alphaseneca/chronopixel-pcb/chronopixel-pcb.kicad_pcb

## KiCad design chronopixel-pcb.kicad_pcb (2026-10-25)

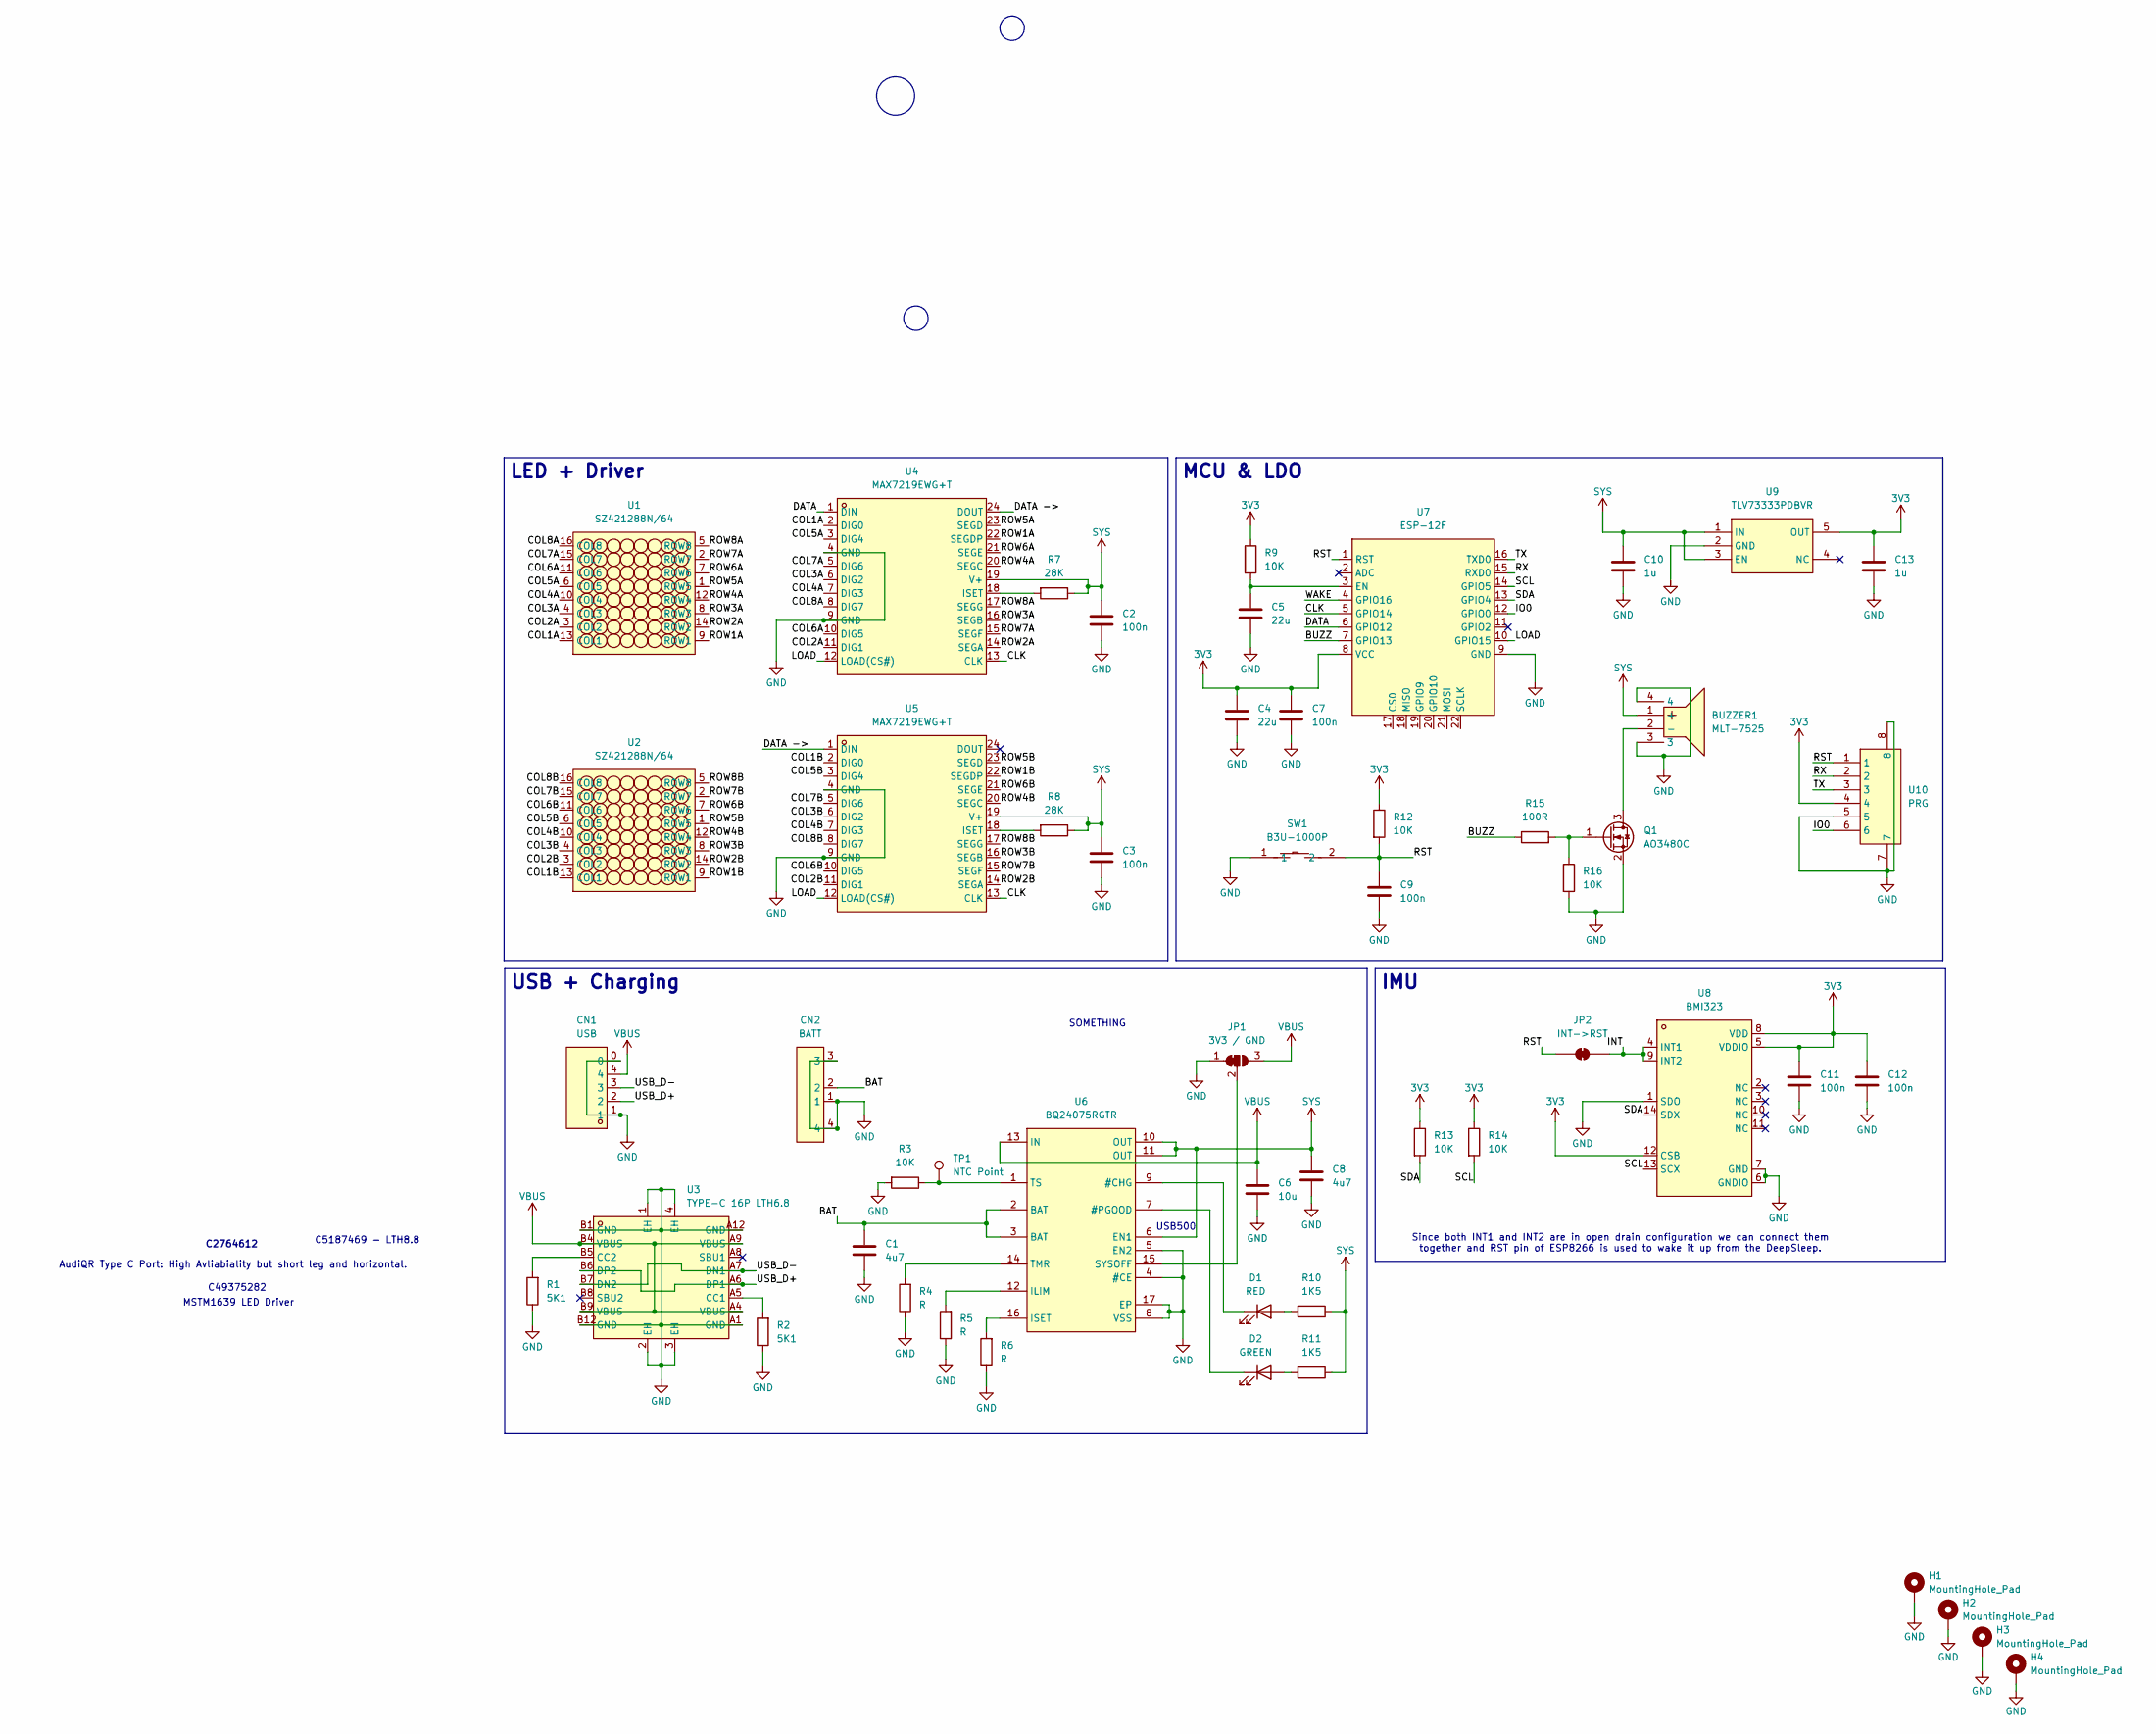
[picture p1: schematic chronopixel-pcb.kicad_sch]

Parts:
BUZZER1: MLT-7525; BUZ-SMD_4P-L7.5-W7.5-P7.59-TL; MPN MLT-7525
C1, C8: 4u7; C_0805_2012Metric; MPN CL21A475KAQNNNE
C2, C3, C7, C9, C11, C12: 100n; C_0603_1608Metric; MPN CL10B104KB8NNNC
C4, C5: 22u; C_0805_2012Metric; MPN CL21A226MAYNNNE
C6: 10u; C_0805_2012Metric; MPN CL21A106KAYNNNE
C10, C13: 1u; C_0805_2012Metric; MPN CL21B105KBFNNNE
CN1: USB; CONN-SMD_BM04B-SRSS-TB; MPN BM04B-SRSS-TB(LF)(SN)
CN2: BATT; CONN-SMD_2P-P1.00_SM02B-SRSS-TB-LF-SN; MPN SM02B-SRSS-TB(LF)(SN)
D1: RED; LED_0603_1608Metric; MPN XL-1608SURC-06
D2: GREEN; LED_0603_1608Metric; MPN XL-1608UGC-04
H1, H2, H3, H4: MountingHole_Pad; MountingHole_2.2mm_M2_Pad_Via
JP1: 3V3 / GND; SolderJumper-3_P1.3mm_Bridged12_RoundedPad1.0x1.5mm
JP2: INT->RST; SolderJumper-2_P1.3mm_Bridged_RoundedPad1.0x1.5mm
Q1: AO3480C; SOT-23; MPN AO3400A
R1, R2: 5K1; R_0603_1608Metric; MPN RC0603FR-075K1L
R3, R9, R12, R13, R14, R16: 10K; R_0603_1608Metric; MPN RC0603FR-0710KL
R4, R5, R6: R; R_0603_1608Metric
R7, R8: 28K; R_0603_1608Metric; MPN RC0603FR-0728KL
R10, R11: 1K5; R_0603_1608Metric; MPN RC0603FR-071K5L
R15: 100R; R_0603_1608Metric; MPN RC0603FR-07100RL
SW1: B3U-1000P; KEY-SMD_B3U-1000PM; MPN B3U-1000P
TP1: NTC Point; TestPoint_Pad_D1.0mm
U1, U2: SZ421288N/64; LED-SEG-TH_SZ421288N-64; MPN SZ421288N/64
U3: TYPE-C 16P LTH6.8; USB-C-SMD_TYPE-C-16P-LTH6.8; MPN TYPE-C 16P LTH6.8
U4, U5: MAX7219EWG+T; SOIC-24_L15.4-W7.5-P1.27-LS10.3-BL; MPN MAX7219EWG+T
U6: BQ24075RGTR; QFN-16_L3.0-W3.0-P0.50-TL-EP1.7; MPN BQ24075RGTR
U7: ESP-12F; ESP-12E; MPN ESP-12F(ESP8266MOD)
U8: BMI323; LGA-14_L3.0-W2.5-P0.50-TL_QMI8658A; MPN BMI323
U9: TLV73333PDBVR; SOT-23-5_L3.0-W1.7-P0.95-LS2.8-BR; MPN TLV73333PDBVR
U10: PRG; CONN-SMD-6P-P1.00_BM06B-SRSS-TB-LF-SN; MPN BM06B-SRSS-TB(LF)(SN)

Connections:
3V3: C4.1, C7.1, C11.1, C12.1, C13.1, R9.1, R12.1, R13.1, R14.1, U7.8 (VCC), U8.5 (VDDIO), U8.8 (VDD), U8.12 (CSB), U9.5 (OUT), U10.4
/BAT: C1.1, CN2.2, U6.2 (BAT), U6.3 (BAT)
/BUZZ: R15.1, U7.7 (GPIO13)
/CLK: U4.13 (CLK), U5.13 (CLK), U7.5 (GPIO14)
/COL1A: U1.13 (COL1), U4.2 (DIG0)
/COL1B: U2.13 (COL1), U5.2 (DIG0)
/COL2A: U1.3 (COL2), U4.11 (DIG1)
/COL2B: U2.3 (COL2), U5.11 (DIG1)
/COL3A: U1.4 (COL3), U4.6 (DIG2)
/COL3B: U2.4 (COL3), U5.6 (DIG2)
/COL4A: U1.10 (COL4), U4.7 (DIG3)
/COL4B: U2.10 (COL4), U5.7 (DIG3)
/COL5A: U1.6 (COL5), U4.3 (DIG4)
/COL5B: U2.6 (COL5), U5.3 (DIG4)
/COL6A: U1.11 (COL6), U4.10 (DIG5)
/COL6B: U2.11 (COL6), U5.10 (DIG5)
/COL7A: U1.15 (COL7), U4.5 (DIG6)
/COL7B: U2.15 (COL7), U5.5 (DIG6)
/COL8A: U1.16 (COL8), U4.8 (DIG7)
/COL8B: U2.16 (COL8), U5.8 (DIG7)
/DATA: U4.1 (DIN), U7.6 (GPIO12)
/DATA ->: U4.24 (DOUT), U5.1 (DIN)
/INT: JP2.2 (B), U8.4 (INT1), U8.9 (INT2)
/IO0: U7.12 (GPIO0), U10.6
/LOAD: U4.12 (LOAD(CS#)), U5.12 (LOAD(CS#)), U7.10 (GPIO15)
/ROW1A: U1.9 (ROW1), U4.22 (SEGDP)
/ROW1B: U2.9 (ROW1), U5.22 (SEGDP)
/ROW2A: U1.14 (ROW2), U4.14 (SEGA)
/ROW2B: U2.14 (ROW2), U5.14 (SEGA)
/ROW3A: U1.8 (ROW3), U4.16 (SEGB)
/ROW3B: U2.8 (ROW3), U5.16 (SEGB)
/ROW4A: U1.12 (ROW4), U4.20 (SEGC)
/ROW4B: U2.12 (ROW4), U5.20 (SEGC)
/ROW5A: U1.1 (ROW5), U4.23 (SEGD)
/ROW5B: U2.1 (ROW5), U5.23 (SEGD)
/ROW6A: U1.7 (ROW6), U4.21 (SEGE)
/ROW6B: U2.7 (ROW6), U5.21 (SEGE)
/ROW7A: U1.2 (ROW7), U4.15 (SEGF)
/ROW7B: U2.2 (ROW7), U5.15 (SEGF)
/ROW8A: U1.5 (ROW8), U4.17 (SEGG)
/ROW8B: U2.5 (ROW8), U5.17 (SEGG)
/RST: C9.1, JP2.1 (A), R12.2, SW1.2, U7.1 (RST), U10.1
/RX: U7.15 (RXD0), U10.2
/SCL: R14.2, U7.14 (GPIO5), U8.13 (SCX)
/SDA: R13.2, U7.13 (GPIO4), U8.14 (SDX)
/TX: U7.16 (TXD0), U10.3
/USB_D+: CN1.2, U3.A6 (DP1), U3.B6 (DP2)
/USB_D-: CN1.3, U3.A7 (DN1), U3.B7 (DN2)
/WAKE: U7.4 (GPIO16)
GND: BUZZER1.3, BUZZER1.4, C1.2, C2.2, C3.2, C4.2, C5.2, C6.2, C7.2, C8.2, C9.2, C10.2, C11.2, C12.2, C13.2, CN1.0, CN1.1, CN2.1, CN2.3, CN2.4, H1.1 (1_1), H2.1 (1_1), H3.1 (1_1), H4.1 (1_1), JP1.1 (A), Q1.2 (S), R1.1, R2.1, R3.2, R4.1, R5.1, R6.1, R16.2, SW1.1, U3.1 (EH), U3.2 (EH), U3.3 (EH), U3.4 (EH), U3.A1 (GND), U3.A12 (GND), U3.B1 (GND), U3.B12 (GND), U4.4 (GND), U4.9 (GND), U5.4 (GND), U5.9 (GND), U6.4 (#CE), U6.5 (EN2), U6.8 (VSS), U6.17 (EP), U7.9 (GND), U8.1 (SDO), U8.6 (GNDIO), U8.7 (GND), U9.2 (GND), U10.5, U10.7, U10.8
unnamed: BUZZER1.2 (-), Q1.3 (D)
unnamed: D1.2 (A), R10.2
unnamed: D1.1 (K), U6.9 (#CHG)
unnamed: D2.2 (A), R11.2
unnamed: D2.1 (K), U6.7 (#PGOOD)
unnamed: JP1.2 (C), U6.15 (SYSOFF)
unnamed: Q1.1 (G), R15.2, R16.1
unnamed: R2.2, U3.A5 (CC1)
unnamed: R1.2, U3.B5 (CC2)
unnamed: R7.2, U4.18 (ISET)
unnamed: R8.2, U5.18 (ISET)
unnamed: R5.2, U6.12 (ILIM)
unnamed: R6.2, U6.16 (ISET)
unnamed: R4.2, U6.14 (TMR)
unnamed: R3.1, TP1.1 (1_1), U6.1 (TS)
unnamed: C5.1, R9.2, U7.3 (EN)
SYS: BUZZER1.1 (+), C2.1, C3.1, C8.1, C10.1, R7.1, R8.1, R10.1, R11.1, U4.19 (V+), U5.19 (V+), U6.6 (EN1), U6.10 (OUT), U6.11 (OUT), U9.1 (IN), U9.3 (EN)
VBUS: C6.1, CN1.4, JP1.3 (B), U3.A4 (VBUS), U3.A9 (VBUS), U3.B4 (VBUS), U3.B9 (VBUS), U6.13 (IN)

Notes on the sheet:
MSTM1639 LED Driver
USB500
AudiQR Type C Port: High Avliabiality but short leg and horizontal.
C2764612
SOMETHING
C49375282
Since both INT1 and INT2 are in open drain configuration we can connect them together and RST pin of ESP8266 is used to wake it up from the DeepSleep.
C5187469 - LTH8.8
IMU
LED + Driver
USB + Charging
MCU & LDO

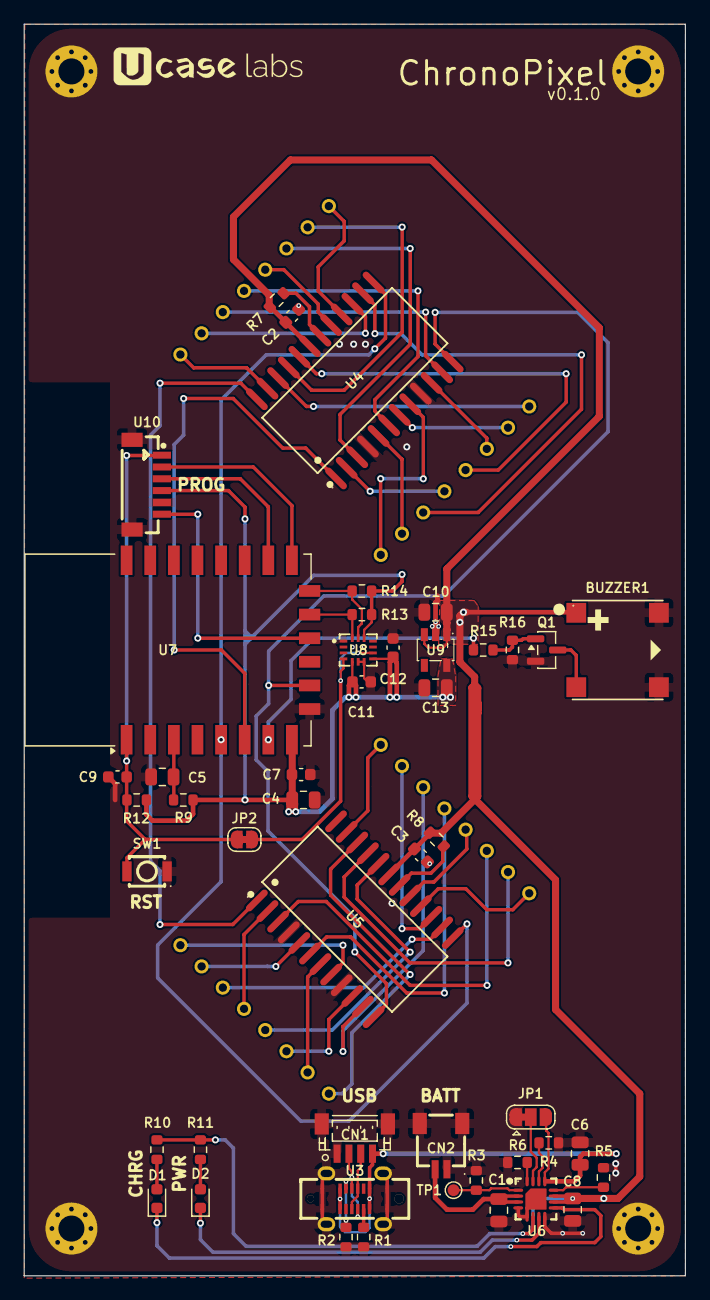
[picture p2: board chronopixel-pcb.kicad_pcb from above]

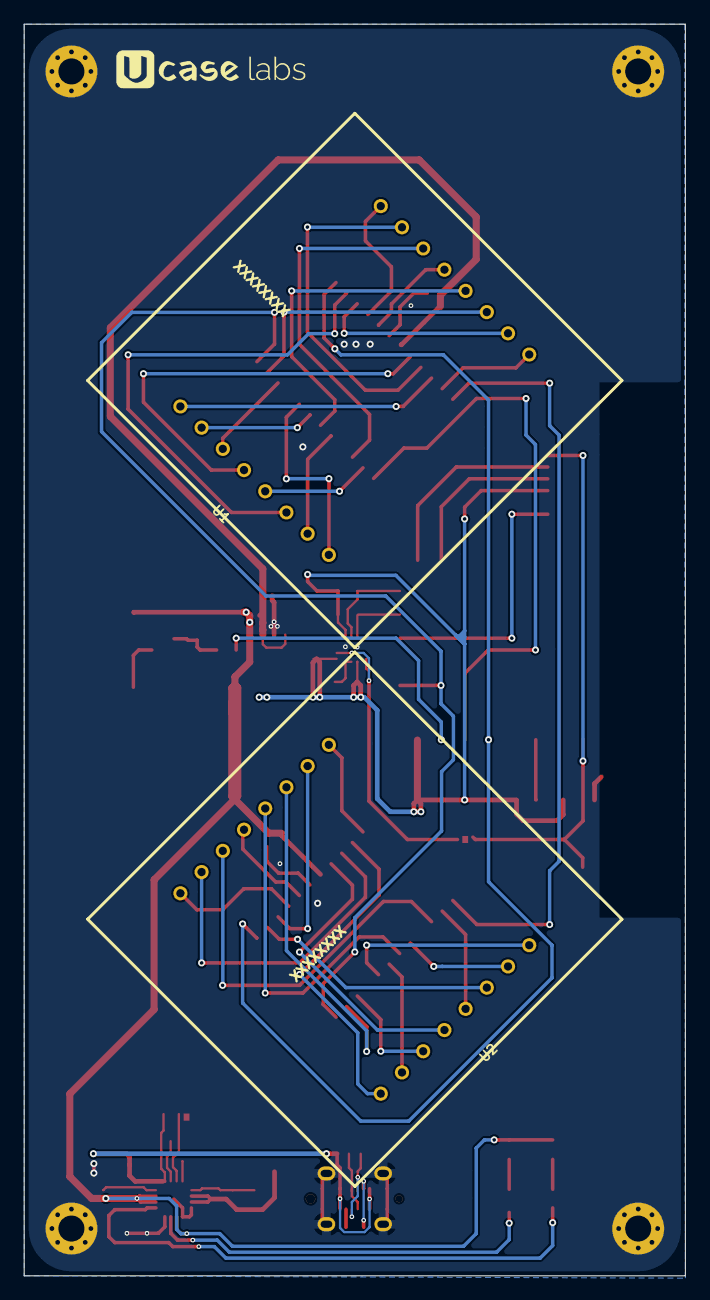
[picture p3: board chronopixel-pcb.kicad_pcb from below]

Board: 2 copper layers, 56.0 x 106.0 mm, 53 parts (2 on the bottom side), 67 nets.
