alphaseneca/chronopixel-pcb/(commit log)

2026-10-25 initial release
    [chronopixel-pcb.kicad_pcb, chronopixel-pcb.kicad_sch]
2026-10-25 docs: add comprehensive hardware documentation and fabrication guide
    - Add board specifications, 3D renders, and key components table (ESP-12F, MAX7219, BMI323, BQ24075)
    - Document dynamic power-path architecture and battery management
    - Include fabrication, JLCPCB assembly, and KiForge artifact references
2026-10-25 docs: document digital sand timer architecture and gravity-sensing hardware
    - Detail how dual LED matrices, BMI323 IMU, and power-path enable the digital hourglass
    - Explain falling sand physics interaction and cordless operation
