alphaseneca/chronopixel-pcb/(notices)

Notices in the files:
README.md:
License: MIT
